CarterKoopa/sapphire_radio/sapphire_radio_esp32.kicad_pcb

## KiCad design sapphire_radio_esp32.kicad_pcb (2026-04-24)

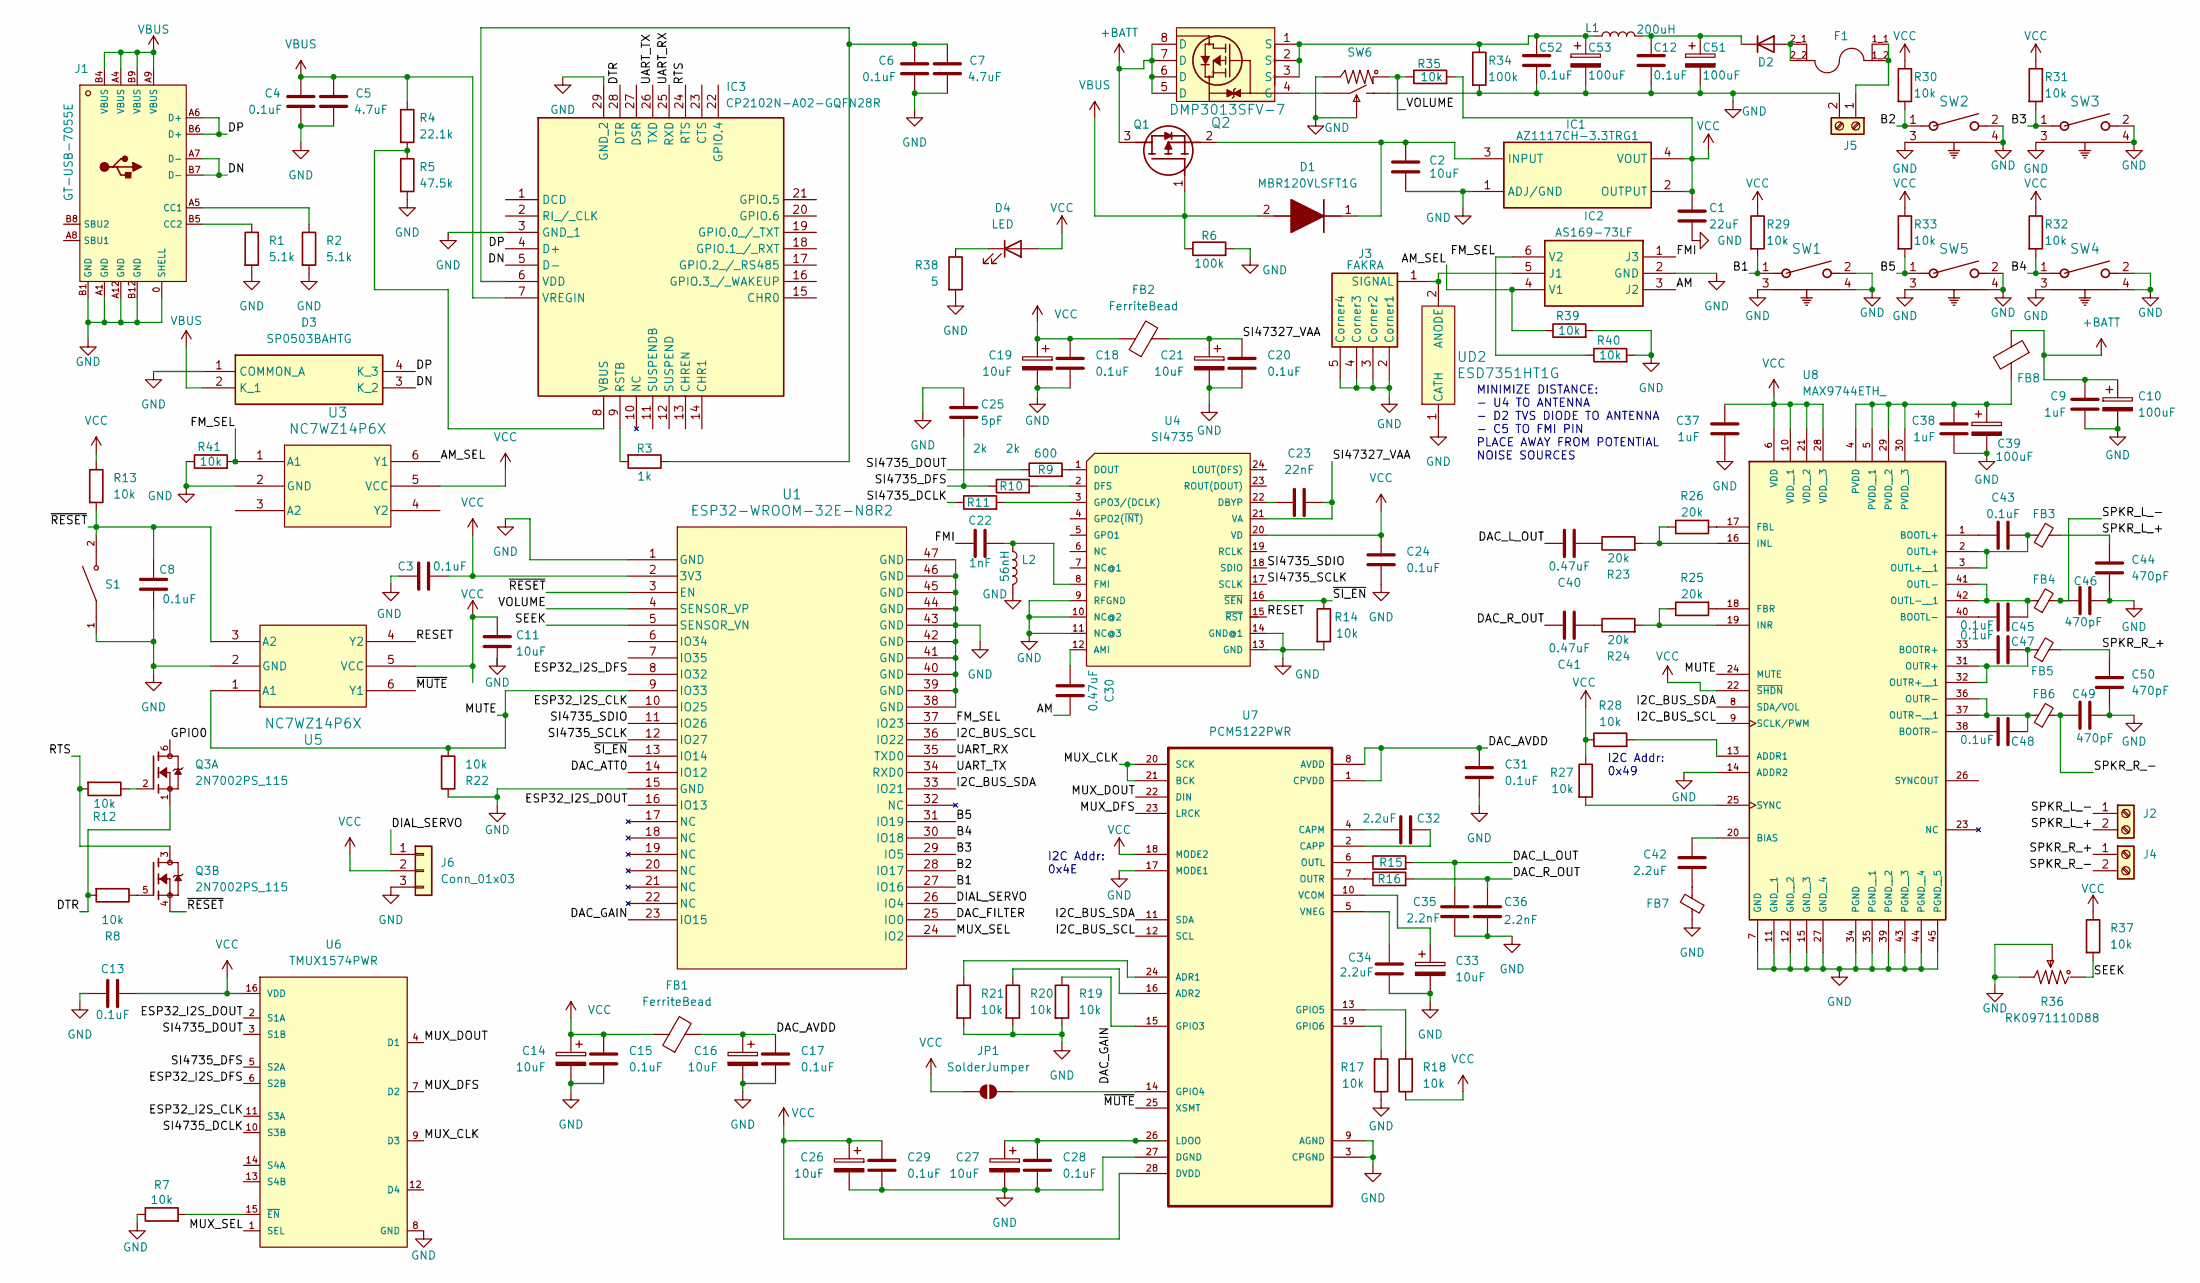
[picture p1: schematic sapphire_radio_esp32.kicad_sch, Volkswagen Sapphire Radio Conversion]

Parts:
C1: 22uF; C_0603_1608Metric
C2, C11: 10uF; C_0603_1608Metric
C3, C4, C6, C8, C12, C13, C43, C45, C47, C48, C52: 0.1uF; C_0603_1608Metric
C5, C7: 4.7uF; C_0603_1608Metric
C9, C37, C38: 1uF; C_0603_1608Metric
C10, C39: 100uF; WCAP-ASLI_6.3X7.7_DXL_; MPN 865080545012; DigikeyPN 732-8511-1-ND
C14, C16, C19, C21, C26, C27, C33: 10uF; CP_Elec_4x5.4; MPN 865080340001; DigikeyPN 732-8411-1-ND
C15, C17, C18, C20, C28, C29, C31: 0.1uF; C_0805_2012Metric; MPN CL21B104KCFNNNE; DigikeyPN 1276-6840-1-ND
C22: 1nF; C_0603_1608Metric; MPN CL10C102JB8NNNC; DigikeyPN 1276-1091-1-ND
C23: 22nF; C_0603_1608Metric; MPN C0603C223K5RACTU; DigikeyPN 399-C0603C223K5RACTUCT-ND
C24: 0.1uF; C_0603_1608Metric; MPN C0603C104K5RACTU; DigikeyPN 399-C0603C104K5RACTUCT-ND
C25: 5pF; C_0603_1608Metric
C30, C40, C41: 0.47uF; C_0603_1608Metric; MPN GRM188R71E474KA12D; DigikeyPN 490-3291-1-ND
C32, C34: 2.2uF; C_0603_1608Metric; MPN GRM188R61E225KA12D; DigikeyPN 490-10731-1-ND
C35, C36: 2.2nF; C_0603_1608Metric; MPN GCM1885C1H222FA16D; DigikeyPN 490-16421-1-ND
C42: 2.2uF; C_0603_1608Metric
C44, C46, C49, C50: 470pF; C_0603_1608Metric
C51, C53: 100uF; CAP_6.3_6.3; MPN EEE-FTH101XAP; DigikeyPN PCE5024CT-ND
D1: MBR120VLSFT1G; SODFL3616X98N; MPN MBR120VLSFT1G; DigikeyPN DMG2305UX-7DICT-ND
D2: D; TO-252-2; MPN SBRD10200; DigikeyPN 1655-SBRD10200CT-ND
D3: SP0503BAHTG; MPN SP0503BAHTG; DigikeyPN F2715CT-ND
D4: LED; JST_ZH_B2B-ZR-SM4-TF_1x02-1MP_P1.50mm_Vertical
F1: 3549-2; FUSE_3549-2; MPN 3549-2; DigikeyPN 36-3549-2-ND
FB1, FB2, FB8: FerriteBead; L_0603_1608Metric; MPN BLM18AG601SN1D; DigikeyPN 490-1014-1-ND
FB3, FB4, FB5, FB6, FB7: FerriteBead_Small; L_0805_2012Metric; MPN MPZ2012S221AT000; DigikeyPN 445-MPZ2012S221AT000CT-ND
IC1: AZ1117CH-3.3TRG1; SOT230P700X180-4N; MPN AZ1117CH-3.3TRG1; DigikeyPN AZ1117CH-3.3TRG1DICT-ND
IC2: AS169-73LF; SOT95P270X145-6N; MPN AS169-73LF; DigikeyPN 863-1002-1-ND
IC3: CP2102N-A02-GQFN28R; QFN50P700X700X80-45N; MPN CP2102N-A02-GQFN28R; DigikeyPN 336-5890-1-ND
J1: GT-USB-7055E; USB-C-SMD_GT-USB-7055E; MPN GT-USB-7055E; LCSCPN C7450622
J2, J4, J5: Screw_Terminal_01x02; PhoenixContact_MSTBA_2,5_2-G-5,08_1x02_P5.08mm_Horizontal
J3: FAKRA; 22913921; MPN 2291392-1; DigikeyPN 17-2291392-1CT-ND
J6: Conn_01x03; JST_PH_B3B-PH-SM4-TB_1x03-1MP_P2.00mm_Vertical
JP1: SolderJumper; SolderJumper-2_P1.3mm_Open_TrianglePad1.0x1.5mm
L1: 200uH; IND-SMD_L28.0-W25.0-74437529203331; MPN PFC-SE2822-221M; LCSCPN C42422422
L2: 56nH; L_0603_1608Metric; MPN LQW18AN56NJ00D; DigikeyPN 490-1177-1-ND
Q1: DMG2305UX-7; SOT96P240X115-3N; MPN DMG2305UX-7; DigikeyPN DMG2305UX-7DICT-ND
Q2: DMP3013SFV-7; POWERDI3333-8_UX_DIO; MPN DMP3013SFV-7; DigikeyPN DMP3013SFV-7DICT-ND
Q3: 2N7002PS_115; SOT65P210X110-6N; MPN 2N7002PS,115; DigikeyPN 1727-4791-1-ND
R1, R2: 5.1k; R_0603_1608Metric
R3: 1k; R_0603_1608Metric
R4: 22.1k; R_0603_1608Metric
R5: 47.5k; R_0603_1608Metric
R6, R34: 100k; R_0603_1608Metric
R7, R8, R12, R13, R14, R17, R18, R19, R20, R21, R22, R27, R28, R29, R30, R31, R32, R33, R35, R37, R39, R40, R41: 10k; R_0603_1608Metric
R9: 600; R_0603_1608Metric
R10, R11: 2k; R_0603_1608Metric
R15, R16: 470; R_0603_1608Metric
R23, R24, R25, R26: 20k; R_0603_1608Metric
R36: RK0971110D88; RES-ADJ-TH_RK097111080R; MPN RK0971110D88; DigikeyPN 4809-RK0971110D88-ND
R38: 5; R_0603_1608Metric
S1: B3U-1000P; SW_B3U-1000P; MPN B3U-1000P; DigikeyPN SW1020CT-ND
SW1, SW2, SW3, SW4, SW5: 1825027-8; SW2_1825027-C_TEC; MPN 1825027-8; DigikeyPN 450-1657-ND
SW6: RK09711110EL; RES-ADJ-TH_RK09711110EL; MPN RK09711110EL; DigikeyPN 4809-RK09711110EL-ND
U1: ESP32-WROOM-32E-N8R2; ESP32­WROOM­32E_EXP; MPN ESP32-WROOM-32E-N8R2; DigikeyPN 5407-ESP32-WROOM-32E-N8R2CT-ND
U3, U5: NC7WZ14P6X; SC70-6_ONS; MPN NC7WZ14P6X; DigikeyPN NC7WZ14P6XCT-ND
U4: SI4735; SSOP24-0.635-8.65X4MM; MPN SI4735-D60-GU; DigikeyPN 336-2140-ND
U6: TMUX1574PWR; Texas_Instruments-PW0016A-0-0-IPC_A; MPN TMUX1574PWR; DigikeyPN 296-53444-1-ND
U7: PCM5122PWR; SOP65P640X120-28N; MPN PCM5122PWR; DigikeyPN 296-35527-1-ND
U8: MAX9744ETH_; QFN50P700X700X80-45N; MPN MAX9744ETH+; DigikeyPN MAX9744ETH+-ND
UD2: ESD7351HT1G; DIO_MM3Z3V0T1G; MPN ESD7351HT1G; DigikeyPN ESD7351HT1GOSCT-ND

Connections:
+BATT: C9.1, C10.1, FB8.1, Q1.3 (D), Q2.5 (D), Q2.6 (D), Q2.7 (D), Q2.8 (D)
/AM: C30.1, IC2.3 (J2)
/AM_SEL: IC2.4 (V1), R39.1, U3.6 (Y1)
/B1: R29.2, SW1.1, U1.27 (IO16)
/B2: R30.2, SW2.1, U1.28 (IO17)
/B3: R31.2, SW3.1, U1.29 (IO5)
/B4: R32.2, SW4.1, U1.30 (IO18)
/B5: R33.2, SW5.1, U1.31 (IO19)
/DAC_ATT0: U1.14 (IO12)
/DAC_AVDD: C16.1, C17.1, C31.1, FB1.2, U7.1 (CPVDD), U7.8 (AVDD)
/DAC_FILTER: U1.25 (IO0)
/DAC_GAIN: R19.1, U1.23 (IO15), U7.15 (GPIO3)
/DAC_L_OUT: C35.1, C40.1, R15.2
/DAC_R_OUT: C36.1, C41.1, R16.2
/DIAL_SERVO: J6.1, U1.26 (IO4)
/DN: D3.3 (K_2), IC3.5 (D-), J1.A7 (D-), J1.B7 (D-)
/DP: D3.4 (K_3), IC3.4 (D+), J1.A6 (D+), J1.B6 (D+)
/DTR: IC3.28 (DTR), Q3.1, R8.2
/ESP32_I2S_CLK: U1.10 (IO25), U6.11 (S3A)
/ESP32_I2S_DFS: U1.8 (IO32), U6.6 (S2B)
/ESP32_I2S_DOUT: U1.16 (IO13), U6.2 (S1A)
/FMI: C22.1, IC2.1 (J3)
/FM_SEL: IC2.6 (V2), R40.1, R41.2, U1.37 (IO23), U3.1 (A1)
/GPIO0: Q3.6
/I2C_BUS_SCL: U1.36 (IO22), U7.12 (SCL), U8.9 (SCLK/PWM)
/I2C_BUS_SDA: U1.33 (IO21), U7.11 (SDA), U8.8 (SDA/VOL)
/MUTE: R22.2, U1.9 (IO33), U5.1 (A1), U8.24 (MUTE)
/MUX_CLK: U6.9 (D3), U7.20 (SCK), U7.21 (BCK)
/MUX_DFS: U6.7 (D2), U7.23 (LRCK)
/MUX_DOUT: U6.4 (D1), U7.22 (DIN)
/MUX_SEL: U1.24 (IO2), U6.1 (SEL)
/RESET: U4.15 (~RST), U5.4 (Y2)
/RTS: IC3.24 (RTS), Q3.3, R12.2
/SEEK: R36.1, R37.2, U1.5 (SENSOR_VN)
/SI4735_DCLK: R11.1, U6.10 (S3B)
/SI4735_DFS: C25.2, R10.1, U6.5 (S2A)
/SI4735_DOUT: R9.1, U6.3 (S1B)
/SI4735_SCLK: U1.12 (IO27), U4.17 (SCLK)
/SI4735_SDIO: U1.11 (IO26), U4.18 (SDIO)
/SI47327_VAA: C20.1, C21.1, C23.2, FB2.2, U4.21 (VA)
/SPKR_L_+: C44.1, FB3.2, J2.2
/SPKR_L_-: C46.1, FB4.2, J2.1
/SPKR_R_+: C50.1, FB5.2, J4.1
/SPKR_R_-: C49.1, FB6.2, J4.2
/UART_RX: IC3.25 (RXD), U1.35 (TXD0)
/UART_TX: IC3.26 (TXD), U1.34 (RXD0)
/VOLUME: R35.1, SW6.4, U1.4 (SENSOR_VP)
/~MUTE: U5.6 (Y1), U7.25 (XSMT)
/~RESET: C8.1, Q3.4, R13.2, S1.2, U1.3 (EN), U5.3 (A2)
/~SI_EN: R14.1, U1.13 (IO14), U4.16 (~SEN)
GND: C1.2, C2.2, C3.1, C4.2, C5.2, C6.2, C7.2, C8.2, C9.2, C10.2, C11.2, C12.2, C13.1, C14.2, C15.2, C16.2, C17.2, C18.2, C19.2, C20.2, C21.2, C24.2, C25.1, C26.2, C27.2, C28.2, C29.2, C31.2, C33.2, C34.1, C35.2, C36.2, C37.2, C38.2, C39.2, C44.2, C46.2, C49.2, C50.2, C51.2, C52.2, C53.2, D3.1 (COMMON_A), FB7.1, IC1.1 (ADJ/GND), IC2.2 (GND), IC3.3 (GND_1), IC3.29 (GND_2), J1.0 (SHELL), J1.A1 (GND), J1.A12 (GND), J1.B1 (GND), J1.B12 (GND), J3.2 (Corner1), J3.3 (Corner2), J3.4 (Corner3), J3.5 (Corner4), J5.2, J6.3, L2.2, R1.2, R2.2, R5.2, R6.2, R7.1, R14.2, R17.1, R19.2, R20.2, R21.2, R22.1, R34.2, R36.2, R36.3, R38.2, R39.2, R40.2, R41.1, S1.1, SW1.2, SW1.3, SW1.4, SW2.2, SW2.3, SW2.4, SW3.2, SW3.3, SW3.4, SW4.2, SW4.3, SW4.4, SW5.2, SW5.3, SW5.4, SW6.2, SW6.3, SW6.5, U1.1 (GND), U1.15 (GND), U1.38 (GND), U1.39 (GND), U1.40 (GND), U1.41 (GND), U1.42 (GND), U1.43 (GND), U1.44 (GND), U1.45 (GND), U1.46 (GND), U1.47 (GND), U3.2 (GND), U4.9 (RFGND), U4.10 (NC@2), U4.11 (NC@3), U4.13 (GND), U4.14 (GND@1), U5.2 (GND), U6.8 (GND), U7.3 (CPGND), U7.9 (AGND), U7.17 (MODE1), U7.27 (DGND), U8.7 (GND), U8.11 (GND__1), U8.12 (GND__2), U8.14 (ADDR2), U8.15 (GND__3), U8.27 (GND__4), U8.34 (PGND), U8.35 (PGND__1), U8.39 (PGND__2), U8.43 (PGND__3), U8.44 (PGND__4), U8.45 (PGND__5), UD2.1 (CATH)
unnamed: C40.2, R23.1
unnamed: C41.2, R24.1
unnamed: C42.2, FB7.2
unnamed: C52.1, C53.1, L1.1, Q2.1 (S), Q2.2 (S), Q2.3 (S), R34.1
unnamed: C2.1, D1.1 (K), IC1.3 (INPUT), Q1.2 (S)
unnamed: D2.2 (A), F1.2_1, F1.2_2
unnamed: C12.1, C51.1, D2.1 (K), L1.2
unnamed: D4.1 (K), R38.1
unnamed: IC2.5 (J1), J3.1 (SIGNAL), UD2.2 (ANODE)
unnamed: IC3.9 (RSTB), R3.2
unnamed: IC3.8 (VBUS), R4.2, R5.1
unnamed: C6.1, C7.1, IC3.6 (VDD), R3.1
unnamed: J1.A5 (CC1), R2.1
unnamed: J1.B5 (CC2), R1.1
unnamed: F1.1_1, F1.1_2, J5.1
unnamed: JP1.2 (B), U7.14 (GPIO4)
unnamed: Q2.4 (G), SW6.1
unnamed: Q3.2, R12.1
unnamed: Q3.5, R8.1
unnamed: C30.2, U4.12 (AMI)
unnamed: C23.1, U4.22 (DBYP)
unnamed: R10.2, U4.2 (DFS)
unnamed: R9.2, U4.1 (DOUT)
unnamed: C22.2, L2.1, U4.8 (FMI)
unnamed: R11.2, U4.3 (GPO3/(DCLK))
unnamed: R7.2, U6.15 (~EN)
unnamed: R21.1, U7.24 (ADR1)
unnamed: R20.1, U7.16 (ADR2)
unnamed: C32.1, U7.4 (CAPM)
unnamed: C32.2, U7.2 (CAPP)
unnamed: R18.2, U7.13 (GPIO5)
unnamed: R17.2, U7.19 (GPIO6)
unnamed: C27.1, C28.1, U7.26 (LDOO)
unnamed: R15.1, U7.6 (OUTL)
unnamed: R16.1, U7.7 (OUTR)
unnamed: C33.1, U7.10 (VCOM)
unnamed: C34.2, U7.5 (VNEG)
unnamed: R28.2, U8.13 (ADDR1)
unnamed: C42.1, U8.20 (BIAS)
unnamed: C43.1, U8.1 (BOOTL+)
unnamed: C45.1, U8.40 (BOOTL-)
unnamed: C47.1, U8.33 (BOOTR+)
unnamed: C48.1, U8.38 (BOOTR-)
unnamed: R26.2, U8.17 (FBL)
unnamed: R25.2, U8.18 (FBR)
unnamed: R23.2, R26.1, U8.16 (INL)
unnamed: R24.2, R25.1, U8.19 (INR)
unnamed: C43.2, FB3.1, U8.2 (OUTL+), U8.3 (OUTL+__1)
unnamed: C45.2, FB4.1, U8.41 (OUTL-), U8.42 (OUTL-__1)
unnamed: C47.2, FB5.1, U8.31 (OUTR+), U8.32 (OUTR+__1)
unnamed: C48.2, FB6.1, U8.36 (OUTR-), U8.37 (OUTR-__1)
unnamed: C38.1, C39.1, FB8.2, U8.4 (PVDD), U8.5 (PVDD__1), U8.29 (PVDD__2), U8.30 (PVDD__3)
unnamed: R27.2, U8.25 (SYNC)
VBUS: C4.1, C5.1, D1.2 (A), D3.2 (K_1), IC3.7 (VREGIN), J1.A4 (VBUS), J1.A9 (VBUS), J1.B4 (VBUS), J1.B9 (VBUS), Q1.1 (G), R4.1, R6.1
VCC: C1.1, C3.2, C11.1, C13.2, C14.1, C15.1, C18.1, C19.1, C24.1, C26.1, C29.1, C37.1, D4.2 (A), FB1.1, FB2.1, IC1.2 (OUTPUT), IC1.4 (VOUT), J6.2, JP1.1 (A), R13.1, R18.1, R27.1, R28.1, R29.1, R30.1, R31.1, R32.1, R33.1, R35.2, R37.1, U1.2 (3V3), U3.5 (VCC), U4.20 (VD), U5.5 (VCC), U6.16 (VDD), U7.18 (MODE2), U7.28 (DVDD), U8.6 (VDD), U8.10 (VDD__1), U8.21 (VDD__2), U8.22 (~SHDN), U8.28 (VDD__3)

Notes on the sheet:
MINIMIZE DISTANCE: - U4 TO ANTENNA - D2 TVS DIODE TO ANTENNA - C5 TO FMI PIN PLACE AWAY FROM POTENTIAL NOISE SOURCES
I2C Addr: 0x4E
I2C Addr: 0x49

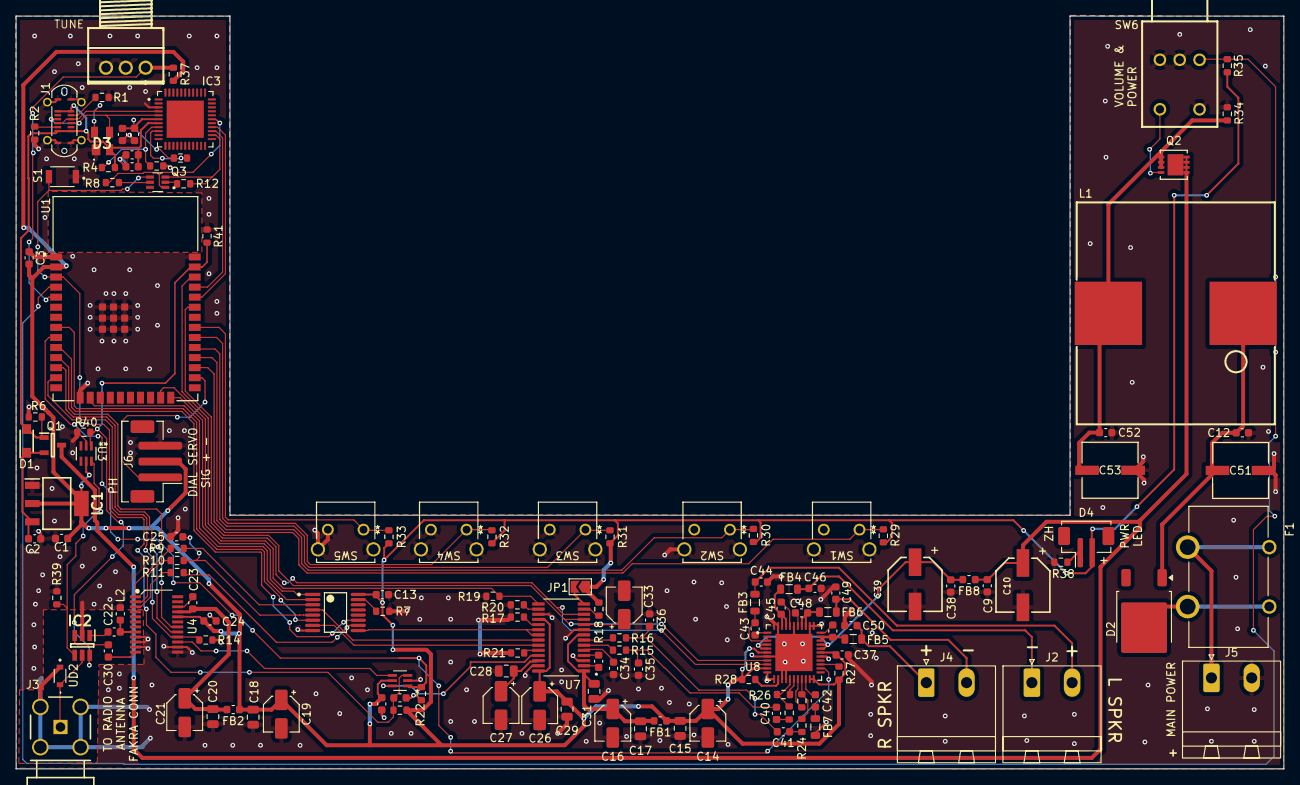
[picture p2: board sapphire_radio_esp32.kicad_pcb from above]

Board: 2 copper layers, 160.0 x 95.0 mm, 137 parts (0 on the bottom side), 103 nets.
