CarterKoopa/sapphire_radio/(commit log)

2026-03-28 Initial schematic commit
    [sapphire_radio_esp32.kicad_pcb, sapphire_radio_esp32.kicad_sch]
2026-03-28 Add KiCad gitignore template
2026-03-28 Add fuse holder
    [sapphire_radio_esp32.kicad_sch]
2026-04-13 Add power filtering and pots
    [sapphire_radio_esp32.kicad_pcb, sapphire_radio_esp32.kicad_sch]
2026-04-15 Add board first pass; move ESP32 GPIO to allow easier routing
    [sapphire_radio_esp32.kicad_pcb, sapphire_radio_esp32.kicad_sch]
2026-04-23 Final WROOM revision
    [sapphire_radio_esp32.kicad_pcb, sapphire_radio_esp32.kicad_sch]
2026-04-24 Move fakra to board edge; move associated parts; silkscreen
    [sapphire_radio_esp32.kicad_pcb, sapphire_radio_esp32.kicad_sch]
